PerryXu1/high-voltage-controller/README.md

# high-voltage-controller
PCB to control the output of a high-voltage (30kV) power supply and relay voltage/current data from it
