PerryXu1/high-voltage-controller/Hardware/Components/STM32G431C6T6/Altium/STM32G431C6T6/LQFP48-7x7mm.step

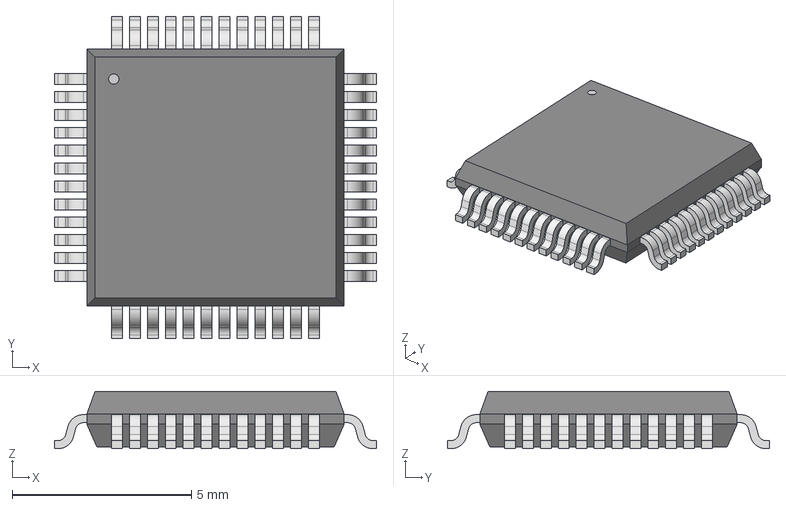
[picture p1: CAD file, 2026-06-20]
Hardware/Components/STM32G431C6T6/Altium/STM32G431C6T6/LQFP48-7x7mm.step
8.99 x 8.99 x 1.60 mm
