PerryXu1/high-voltage-controller/Hardware/Components/TLV9002QDRQ1/Altium/TLV9002QDRQ1/SOIC8_D_TEX.step

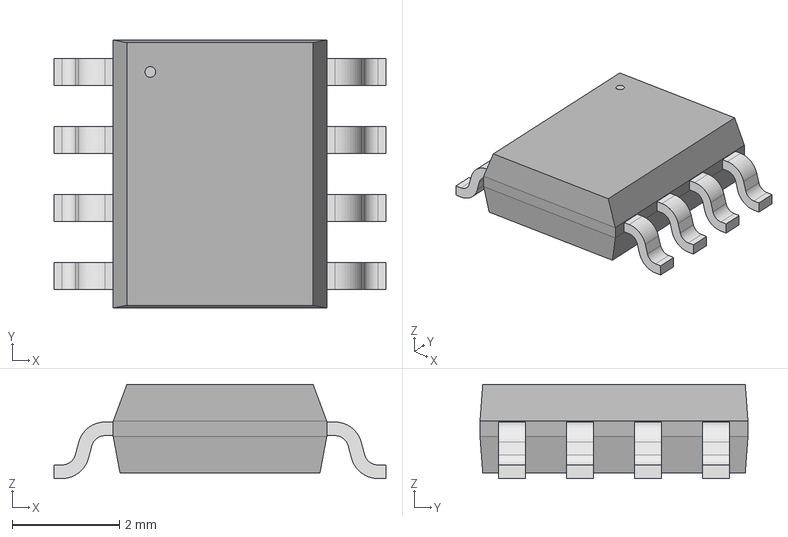
[picture p2: CAD file, 2026-06-20]
Hardware/Components/TLV9002QDRQ1/Altium/TLV9002QDRQ1/SOIC8_D_TEX.step
6.20 x 5.00 x 1.75 mm
