PerryXu1/high-voltage-controller/Hardware/Components/TLV9002QDRQ1/D0008A.stp

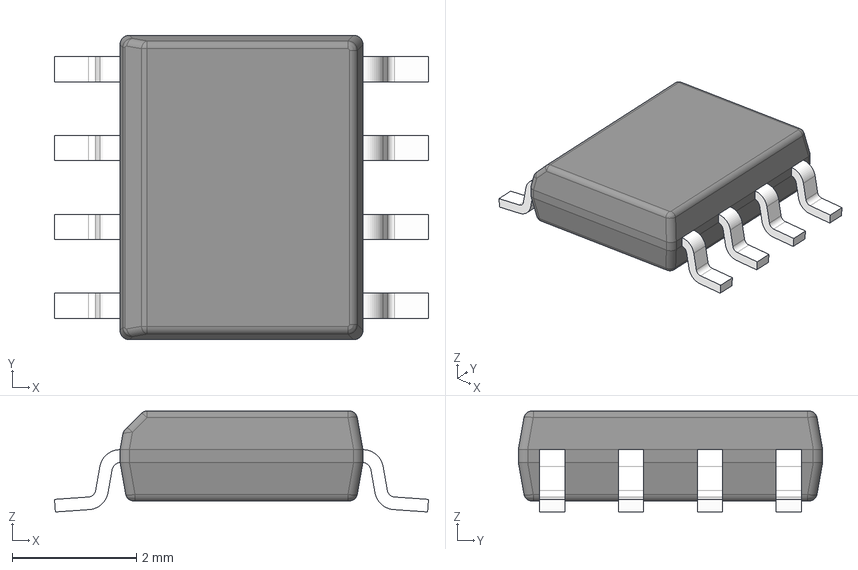
[picture p3: CAD file, 2026-06-20]
Hardware/Components/TLV9002QDRQ1/D0008A.stp
6.02 x 4.90 x 1.63 mm
BODY-SO
LEAD-D0008A x 8
