PerryXu1/high-voltage-controller/Hardware/Components/USB4105_GF_A/USB4105-GF-A.STEP

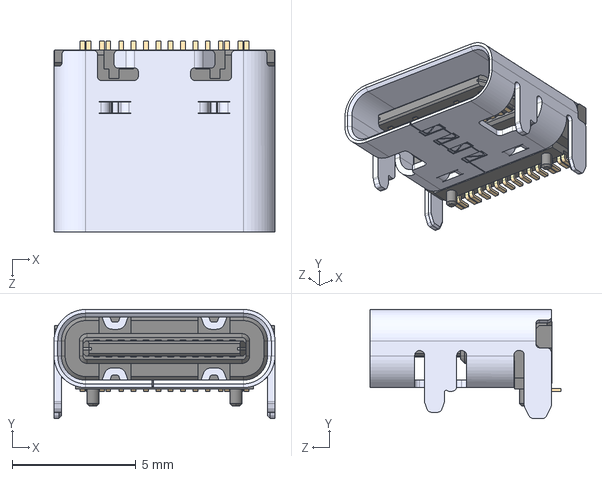
[picture p4: CAD file, 2026-06-20]
Hardware/Components/USB4105_GF_A/USB4105-GF-A.STEP
8.94 x 4.41 x 7.71 mm
