PerryXu1/high-voltage-controller/Hardware/Components/ISO7721FDWR/DW0016B.stp

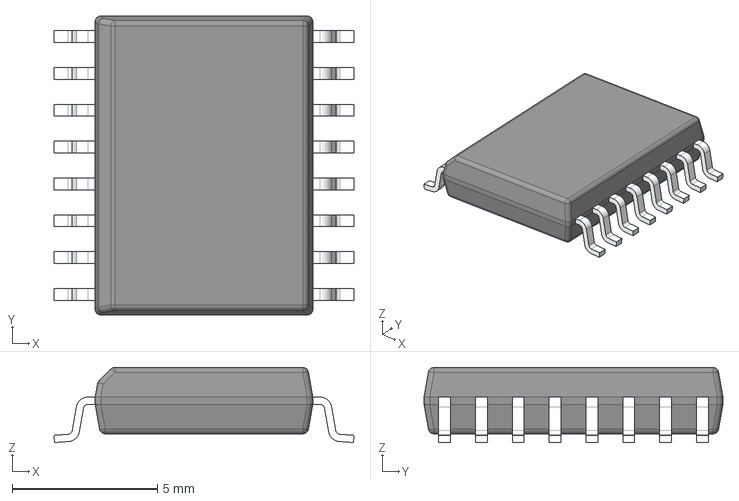
[picture p5: CAD file, 2026-06-20]
Hardware/Components/ISO7721FDWR/DW0016B.stp
10.3 x 10.3 x 2.59 mm
BODY-SOIC
LEAD-DW0016 x 16
