PerryXu1/high-voltage-controller/(list of files, cad)

Other CAD files:
Hardware/Components/STM32G431C6T6/LQFP48-7x7mm.step
