PerryXu1/high-voltage-controller/Hardware/high_voltage_controller/high_voltage_controller.pdf

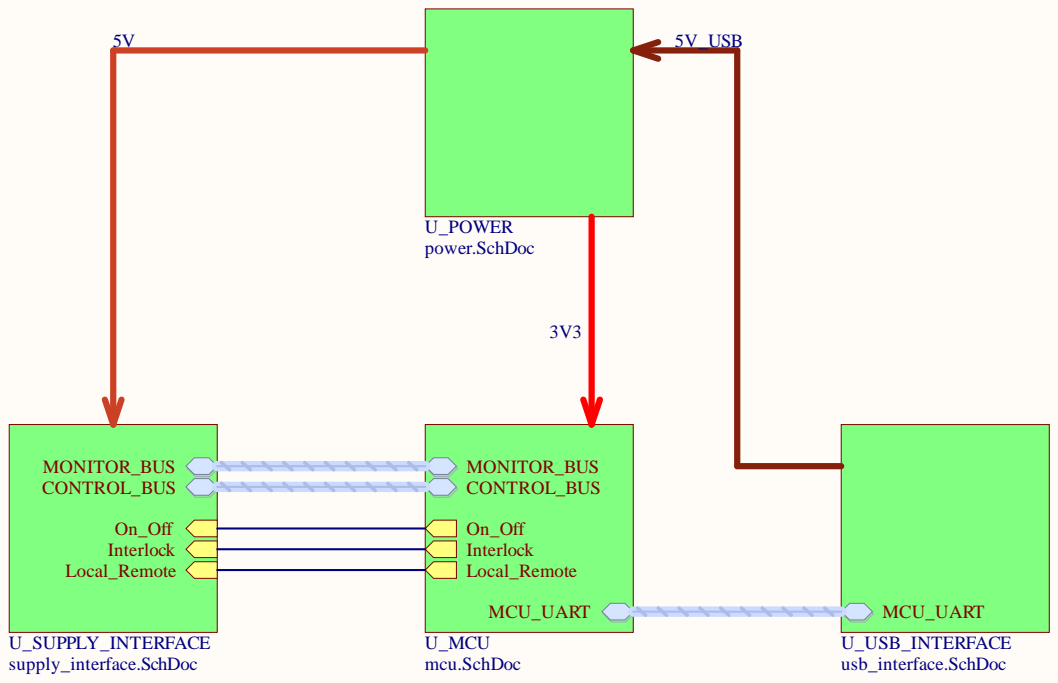
[picture p6: page 1]

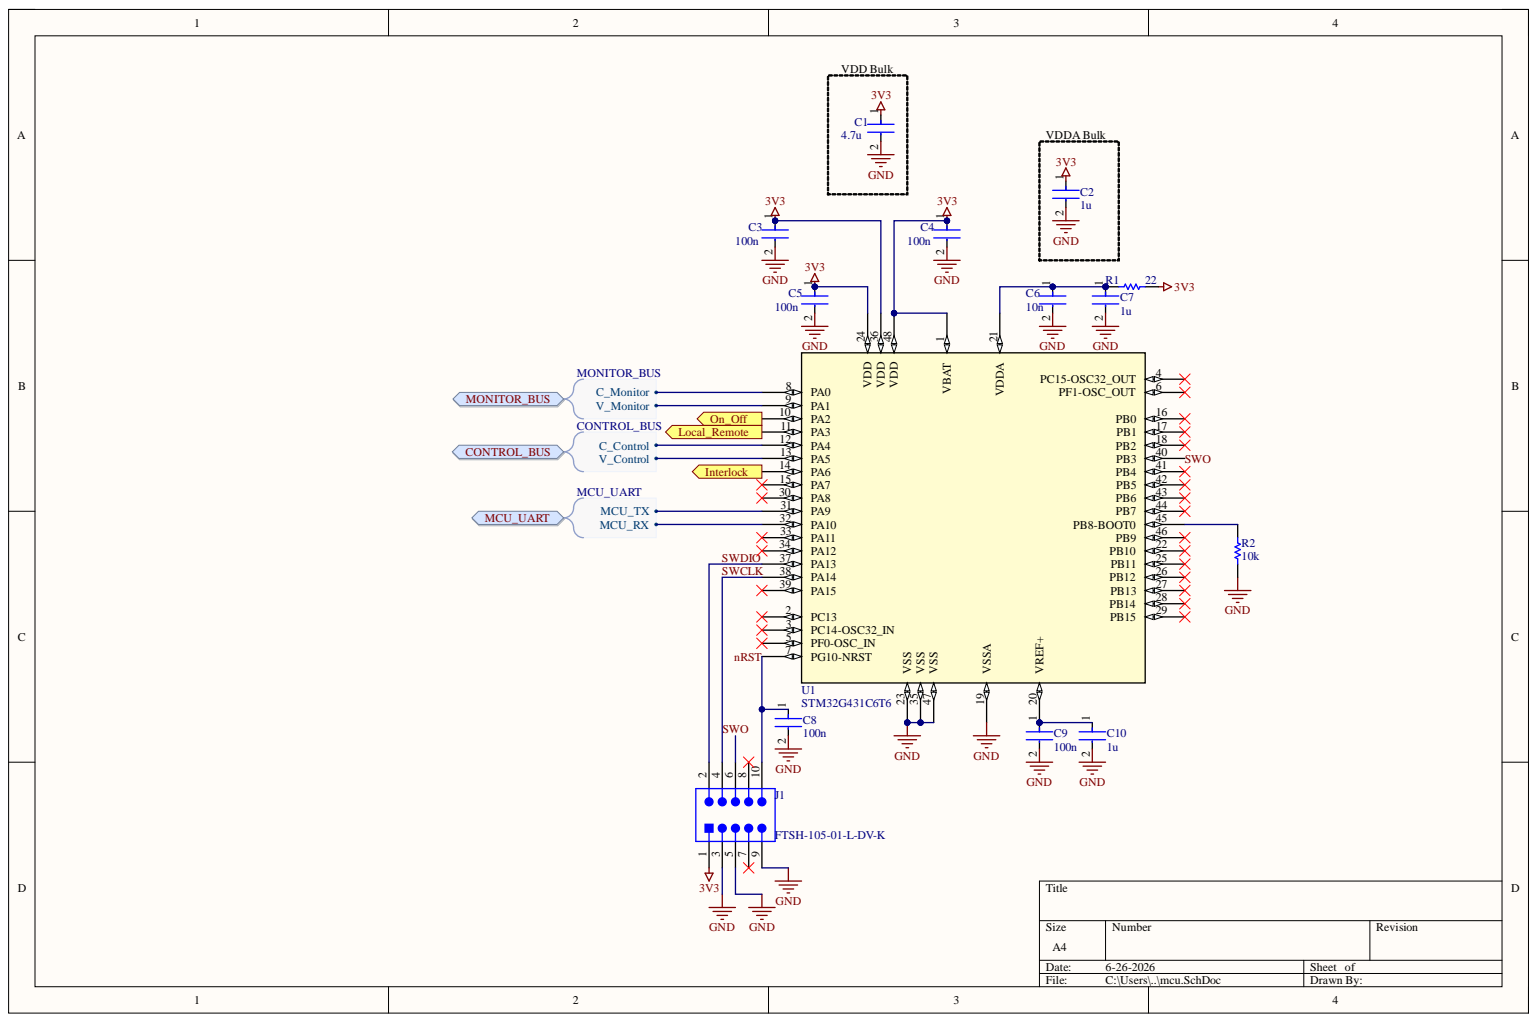
[picture p7: page 2]

SWCLK | PA14 38
nRST SWO | PA15 39

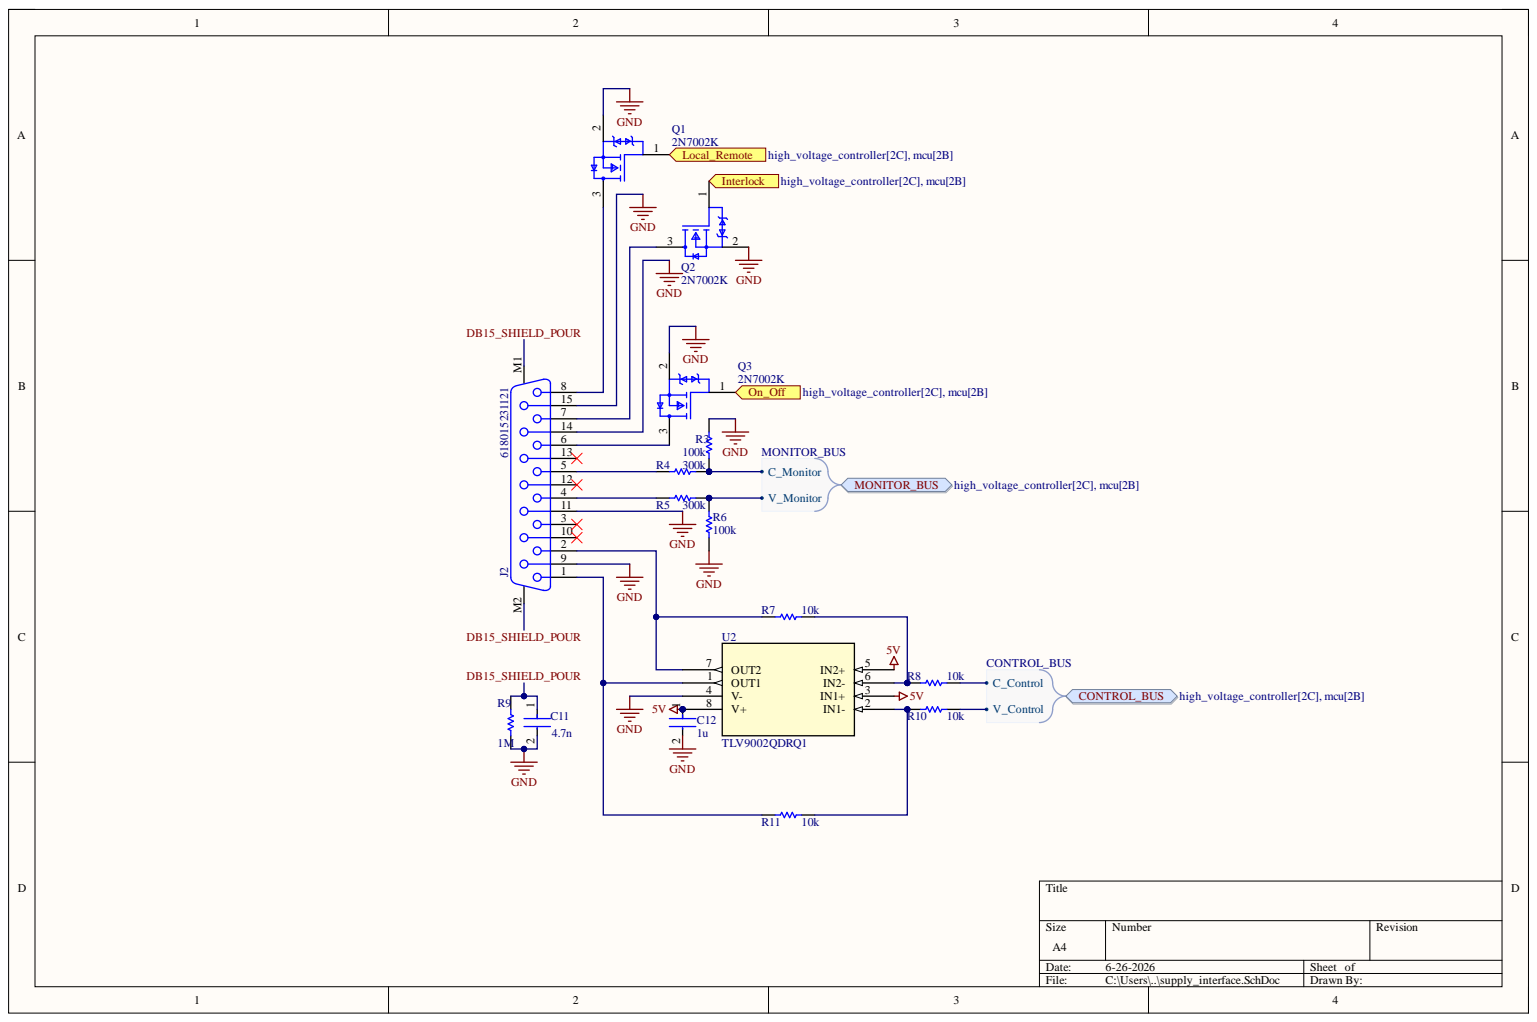
[picture p8: page 3]

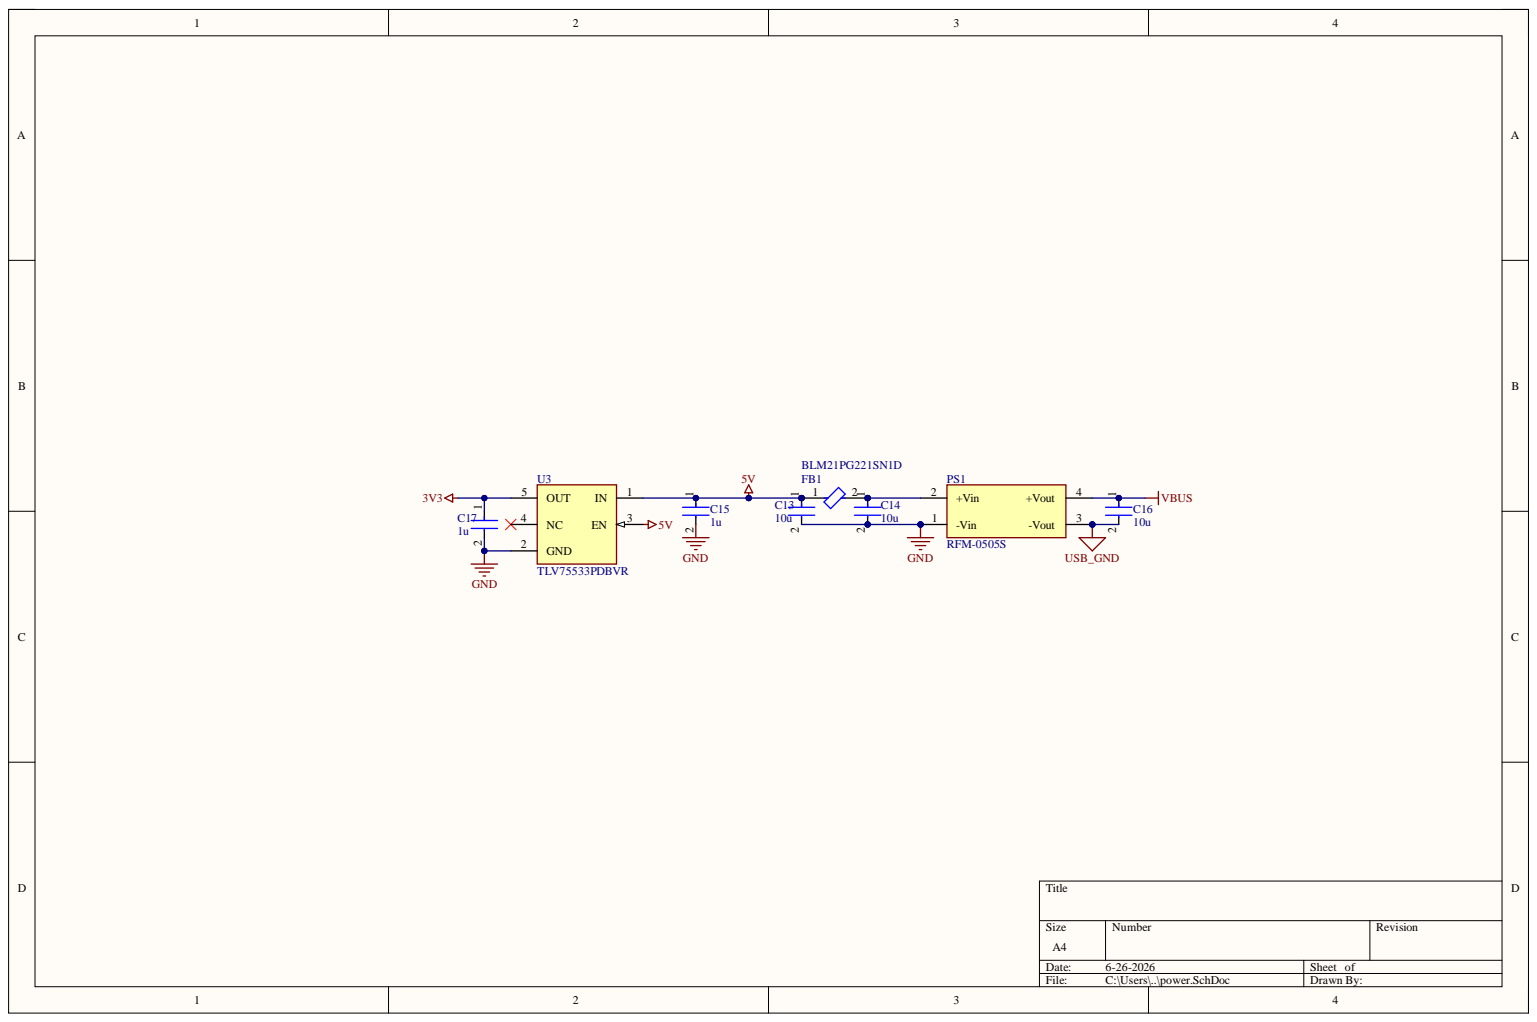
[picture p9: page 4]

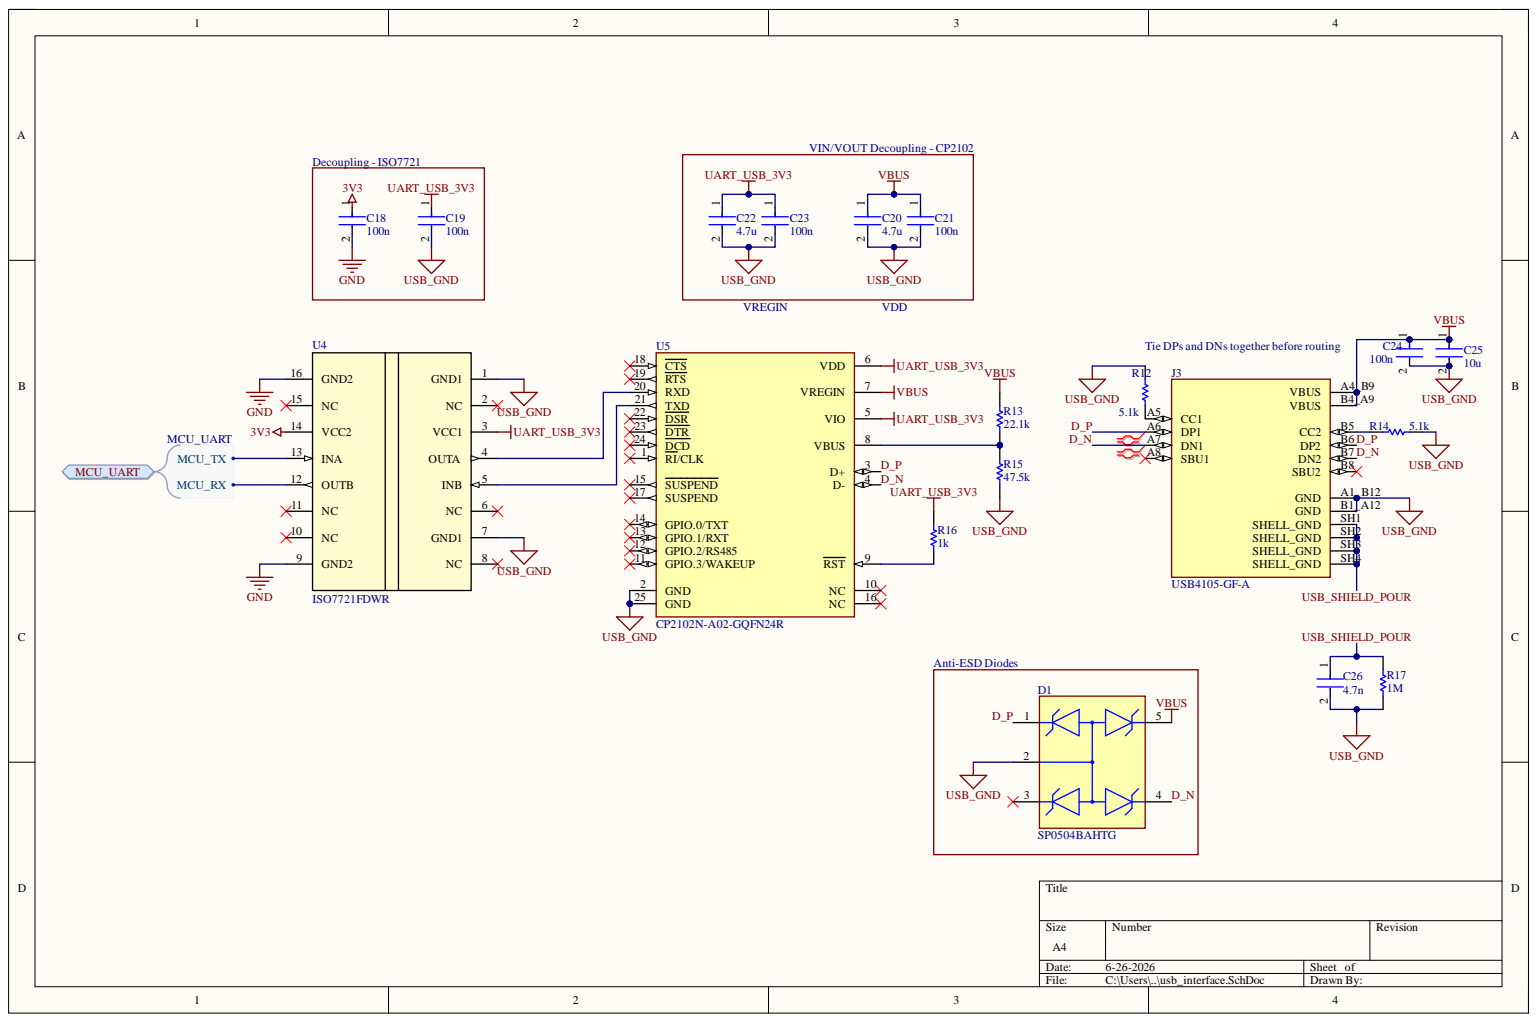
[picture p10: page 5]

3 | USB_ G N D | 2 2

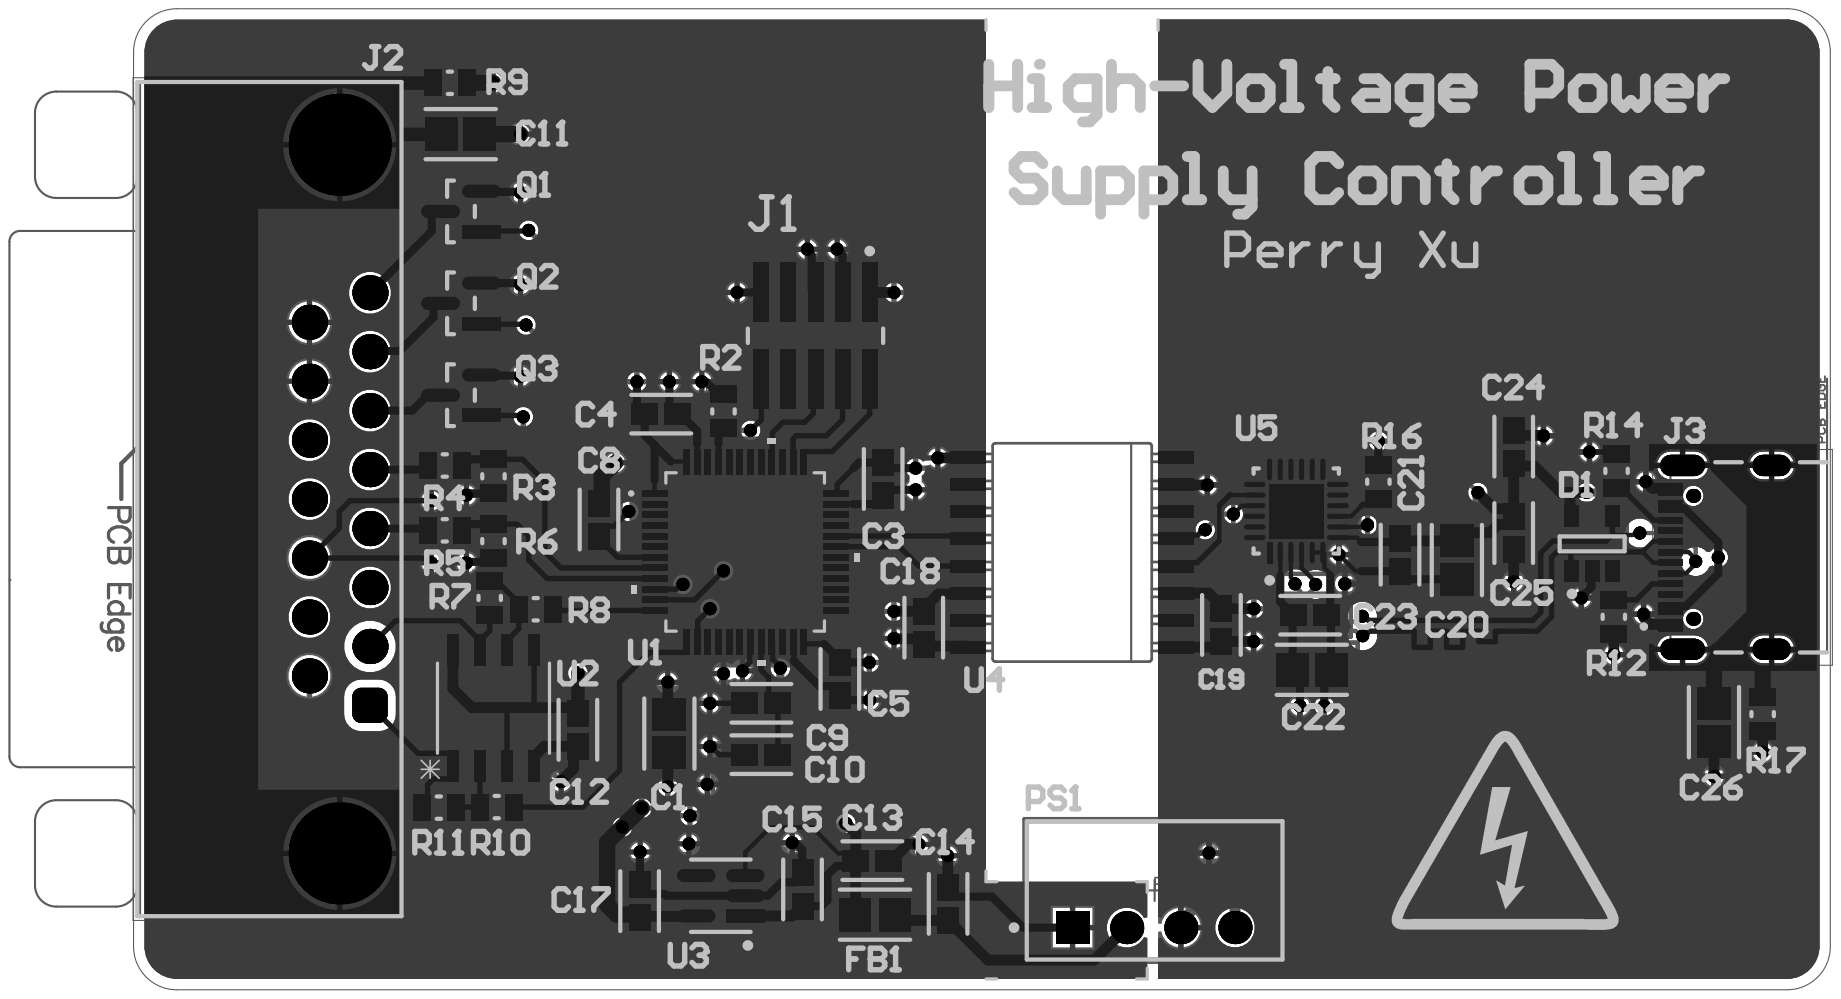
[picture p11: page 6]
