PerryXu1/high-voltage-controller/(list of files, drawings)

Other design files:
Hardware/Components/618015231121/618015231121.PcbLib
Hardware/Components/618015231121/618015231121.SchLib
Hardware/Components/618015231121/618015231121/618015231121.PcbLib
Hardware/Components/618015231121/618015231121/618015231121.SchLib
Hardware/Components/BLM21PG221SN1D/BLM21PG221SN1D.PcbLib
Hardware/Components/BLM21PG221SN1D/BLM21PG221SN1D.SchLib
Hardware/Components/BLM21PG221SN1D/BLM21PG221SN1D/BLM21PG221SN1D.PcbLib
Hardware/Components/BLM21PG221SN1D/BLM21PG221SN1D/BLM21PG221SN1D.SchLib
Hardware/Components/CC0603KRX7R9BB104/CC0603KRX7R9BB104.PcbLib
Hardware/Components/CC0603KRX7R9BB104/CC0603KRX7R9BB104.SchLib
Hardware/Components/CC0603KRX7R9BB104/CC0603KRX7R9BB104/CC0603KRX7R9BB104.PcbLib
Hardware/Components/CC0603KRX7R9BB104/CC0603KRX7R9BB104/CC0603KRX7R9BB104.SchLib
Hardware/Components/CC0805KKX5R5BB475/CC0805KKX5R5BB475.PcbLib
Hardware/Components/CC0805KKX5R5BB475/CC0805KKX5R5BB475.SchLib
Hardware/Components/CC0805KKX5R5BB475/CC0805KKX5R5BB475/CC0805KKX5R5BB475.PcbLib
Hardware/Components/CC0805KKX5R5BB475/CC0805KKX5R5BB475/CC0805KKX5R5BB475.SchLib
Hardware/Components/CP2102N-A02-GQFN24R/CP2102N-A02-GQFN24R.PcbLib
Hardware/Components/CP2102N-A02-GQFN24R/CP2102N-A02-GQFN24R.SchLib
Hardware/Components/CP2102N-A02-GQFN24R/CP2102N-A02-GQFN24R/CP2102N-A02-GQFN24R.PcbLib
Hardware/Components/CP2102N-A02-GQFN24R/CP2102N-A02-GQFN24R/CP2102N-A02-GQFN24R.SchLib
Hardware/Components/FTSH-105-01-L-DV-K/FTSH-105-01-L-DV-K.PcbLib
Hardware/Components/FTSH-105-01-L-DV-K/FTSH-105-01-L-DV-K.SchLib
Hardware/Components/FTSH-105-01-L-DV-K/FTSH-105-01-L-DV-K/FTSH-105-01-L-DV-K.PcbLib
Hardware/Components/FTSH-105-01-L-DV-K/FTSH-105-01-L-DV-K/FTSH-105-01-L-DV-K.SchLib
Hardware/Components/ISO7721FDWR/Altium/ISO7721FDWR.PcbLib
Hardware/Components/ISO7721FDWR/Altium/ISO7721FDWR.SchLib
Hardware/Components/RC0805FR-0710KL/RC0805FR-0710KL.PcbLib
Hardware/Components/RC0805FR-0710KL/RC0805FR-0710KL.SchLib
Hardware/Components/RC0805FR-0710KL/RC0805FR-0710KL/RC0805FR-0710KL.PcbLib
Hardware/Components/RC0805FR-0710KL/RC0805FR-0710KL/RC0805FR-0710KL.SchLib
Hardware/Components/RFM-0505S/RFM-0505S.PcbLib
Hardware/Components/RFM-0505S/RFM-0505S.SchLib
Hardware/Components/RFM-0505S/RFM-0505S/RFM-0505S.PcbLib
Hardware/Components/RFM-0505S/RFM-0505S/RFM-0505S.SchLib
Hardware/Components/SN7002K/SN7002K.PcbLib
Hardware/Components/SN7002K/SN7002K.SchLib
Hardware/Components/SN7002K/SN7002K/SN7002K.PcbLib
Hardware/Components/SN7002K/SN7002K/SN7002K.SchLib
Hardware/Components/SP0504BAHTG/SP0504BAHTG.PcbLib
Hardware/Components/SP0504BAHTG/SP0504BAHTG.SchLib
Hardware/Components/SP0504BAHTG/SP0504BAHTG/SP0504BAHTG.PcbLib
Hardware/Components/SP0504BAHTG/SP0504BAHTG/SP0504BAHTG.SchLib
Hardware/Components/STM32G431C6T6/Altium/STM32G431C6T6/STM32G431C6T6.PcbLib
Hardware/Components/STM32G431C6T6/Altium/STM32G431C6T6/STM32G431C6T6.SchLib
Hardware/Components/TLV9002QDRQ1/Altium/TLV9002QDRQ1/TLV9002QDRQ1.PcbLib
Hardware/Components/TLV9002QDRQ1/Altium/TLV9002QDRQ1/TLV9002QDRQ1.SchLib
Hardware/Components/TLV75533PDBVR/TLV75533PDBVR.PcbLib
Hardware/Components/TLV75533PDBVR/TLV75533PDBVR.SchLib
Hardware/Components/TLV75533PDBVR/TLV75533PDBVR/TLV75533PDBVR.PcbLib
Hardware/Components/TLV75533PDBVR/TLV75533PDBVR/TLV75533PDBVR.SchLib
Hardware/Components/USB4105_GF_A/USB4105-GF-A/GCT_USB4105-GF-A.PcbLib
Hardware/Components/USB4105_GF_A/USB4105-GF-A/USB4105-GF-A.SchLib
Hardware/high_voltage_controller/high_voltage_controller.PcbDoc
Hardware/high_voltage_controller/high_voltage_controller.PcbLib
Hardware/high_voltage_controller/high_voltage_controller.PrjPcb
Hardware/high_voltage_controller/high_voltage_controller.SchDoc
Hardware/high_voltage_controller/high_voltage_controller.SchLib
Hardware/high_voltage_controller/mcu.SchDoc
Hardware/high_voltage_controller/power.SchDoc
Hardware/high_voltage_controller/supply_interface.SchDoc
Hardware/high_voltage_controller/usb_interface.SchDoc
