PerryXu1/high-voltage-controller/Firmware/high-voltage-controller/Core/Src/main.c

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
/* Includes ------------------------------------------------------------------*/
#include "main.h"

/* USER CODE BEGIN Includes */
#include <inttypes.h>

/* USER CODE END Includes */

ADC_HandleTypeDef hadc1;
DMA_HandleTypeDef hdma_adc1;

DAC_HandleTypeDef hdac1;
DMA_HandleTypeDef hdma_dac1_ch2;

TIM_HandleTypeDef htim6;

UART_HandleTypeDef huart1;

/* USER CODE BEGIN PV */
// Data variables
#define MAX_POINTS 1000
#define V_REF 2.5f // use 2.5V analog reference voltage
#define CURRENT_LIMIT_VOLTAGE 0.2f
#define ADC_READ_PERIOD 20 // in ms

// TEST
volatile uint32_t dac_index = 0;
uint16_t current_dac_value = 0;

// GPIO variables
#define CTRL_PORT        GPIOA
#define PIN_OUTPUT_CTRL  GPIO_PIN_10
#define PIN_REMOTE_CTRL  GPIO_PIN_11
#define PIN_INTERLOCK    GPIO_PIN_14

// MCU state logic
typedef enum {
  STATE_WAIT_HEADER,
  STATE_WAIT_PAYLOAD,
  STATE_READY,
  STATE_RUNNING
} AppState_t;

volatile AppState_t sys_state = STATE_WAIT_HEADER;

// RX: Signal Data
typedef struct __attribute__((packed)) {
    char header; // 'D' for data
    uint32_t num_points;
    float time_step;
} DataHeader_t;

DataHeader_t rx_header;
float rx_voltages[MAX_POINTS];
uint16_t dac_buffer[MAX_POINTS]; 
char rx_flag;

// Misc flags
// 2 bytes: rx_cmd[0] = Command (S, O), rx_cmd[1] = Parameter (1 or 0)
// S: start experiment, O: turn off
uint8_t rx_cmd[2];

// TX: ADC Data
uint16_t adc_values[2]; // 0: voltage, 1: current

typedef struct __attribute__((packed)) {
    uint16_t sync_word; // 0xA5A5
    uint16_t v_adc;
    uint16_t i_adc;
} TelemetryPacket_t;

TelemetryPacket_t tx_packet = { .sync_word = 0xA5A5 };
uint32_t last_tx_tick = 0;
/* USER CODE END PV */

void SystemClock_Config(void);
static void MX_GPIO_Init(void);
static void MX_DMA_Init(void);
static void MX_DAC1_Init(void);
static void MX_TIM6_Init(void);
static void MX_ADC1_Init(void);
static void MX_USART1_UART_Init(void);
/* USER CODE BEGIN 0 */
void Configure_TIM6_TimeStep(float dt_minutes) {
  float dt_seconds = dt_minutes * 60.0f;
  HAL_TIM_Base_Stop(&htim6);

  uint32_t prescaler = 15999; 
  uint32_t arr_value = (uint32_t)(dt_seconds * 10000.0f) - 1;

  if (arr_value > 65535) {
      prescaler = 63999; 
      arr_value = (uint32_t)(dt_seconds * 2500.0f) - 1;
  }

  __HAL_TIM_SET_PRESCALER(&htim6, prescaler);
  __HAL_TIM_SET_AUTORELOAD(&htim6, arr_value);

  htim6.Instance->EGR = TIM_EGR_UG;

  __HAL_TIM_SET_COUNTER(&htim6, 0); 

}

void HAL_UART_RxCpltCallback(UART_HandleTypeDef *huart) {
  if (huart->Instance == USART1) {

      // State logic
      switch (sys_state) {
          case STATE_WAIT_HEADER:
              if (rx_header.header == 'D') {
                  sys_state = STATE_WAIT_PAYLOAD;
                  // Read incoming data
                  HAL_UART_Receive_IT(&huart1, (uint8_t*)rx_voltages, rx_header.num_points * sizeof(float));
              } else {
                  // Invalid data; flush and try again
                  HAL_UART_Receive_IT(&huart1, (uint8_t*)&rx_header, sizeof(DataHeader_t));
              }
              break;

          case STATE_WAIT_PAYLOAD:
              // Process data into DAC inputs
              for (uint32_t i = 0; i < rx_header.num_points; i++) {
                  dac_buffer[i] = rx_voltages[i];
              }

              // Set timer speed
              Configure_TIM6_TimeStep(rx_header.time_step);

              // Tell PC the MCU is ready
              uint8_t ready_msg = 'R';
              HAL_UART_Transmit_IT(&huart1, &ready_msg, 1);
              
              sys_state = STATE_READY;

              __HAL_UART_CLEAR_OREFLAG(&huart1);
              __HAL_UART_CLEAR_NEFLAG(&huart1);
              __HAL_UART_CLEAR_FEFLAG(&huart1);

              uint32_t dummy = huart1.Instance->RDR;
              (void)dummy;

              // Now re-arm the interrupt
              HAL_UART_Receive_IT(&huart1, rx_cmd, 2);

              HAL_UART_Receive_IT(&huart1, rx_cmd, 2);
              break;

          case STATE_READY:
          case STATE_RUNNING:
              // S: Start experiment
              if (sys_state == STATE_READY && rx_cmd[0] == 'S') {
                  HAL_TIM_Base_Stop(&htim6);

                  __HAL_DAC_CLEAR_FLAG(&hdac1, DAC_FLAG_DMAUDR2);

                  WRITE_REG(DMA1->IFCR, DMA_IFCR_CTCIF2 | DMA_IFCR_CHTIF2 | DMA_IFCR_CTEIF2 | DMA_IFCR_CGIF2);                  
                  // Set DAC CH2 to output data
                  HAL_DAC_Start_DMA(&hdac1, DAC_CHANNEL_2, (uint32_t*) dac_buffer, rx_header.num_points, DAC_ALIGN_12B_R);
                  HAL_TIM_Base_Start(&htim6);
                  
                  // Set interlock ON
                  HAL_GPIO_WritePin(CTRL_PORT, PIN_OUTPUT_CTRL, GPIO_PIN_SET);
                  sys_state = STATE_RUNNING;
              }

              // O: Turn Off flag
              else if (rx_cmd[0] == 'O') { 
                  HAL_TIM_Base_Stop(&htim6);
                  HAL_DAC_Stop_DMA(&hdac1, DAC_CHANNEL_2);
                  
                  // Set output off
                  HAL_GPIO_WritePin(CTRL_PORT, PIN_OUTPUT_CTRL, GPIO_PIN_RESET);
                  sys_state = STATE_READY;
              }
              // C: Remote / Local Control flag
              else if (rx_cmd[0] == 'C') {
                  if (rx_cmd[1] == 1 || rx_cmd[1] == '1') {
                      HAL_GPIO_WritePin(CTRL_PORT, PIN_REMOTE_CTRL, GPIO_PIN_SET);   // Remote (Pin 11 HIGH)
                  } else if (rx_cmd[1] == 0 || rx_cmd[1] == '0') {
                      HAL_GPIO_WritePin(CTRL_PORT, PIN_REMOTE_CTRL, GPIO_PIN_RESET); // Front Panel / Local (Pin 11 LOW)
                  }
              }
              
              HAL_UART_Receive_IT(&huart1, rx_cmd, 2);
              break;
          
      }
  }
}
/* USER CODE END 0 */

/**
  * @brief  The application entry point.
  * @retval int
  */
int main(void)
{

  /* MCU Configuration--------------------------------------------------------*/

  /* Reset of all peripherals, Initializes the Flash interface and the Systick. */
  HAL_Init();

  /* Configure the system clock */
  SystemClock_Config();

  /* Initialize all configured peripherals */
  MX_GPIO_Init();
  MX_DMA_Init();
  MX_DAC1_Init();
  MX_TIM6_Init();
  MX_ADC1_Init();
  MX_USART1_UART_Init();
  /* USER CODE BEGIN 2 */

  // Set DAC CH1 output | limit / 2 since op amp gain is 2
  uint32_t current_limit_dac_val = (uint32_t) (((CURRENT_LIMIT_VOLTAGE / 2) / V_REF) * 4095.0f);
  HAL_DAC_SetValue(&hdac1, DAC_CHANNEL_1, DAC_ALIGN_12B_R, current_limit_dac_val);
  HAL_DAC_Start(&hdac1, DAC_CHANNEL_1);

  // Start ADC monitoring
  HAL_ADCEx_Calibration_Start(&hadc1, ADC_SINGLE_ENDED);
  HAL_ADC_Start_DMA(&hadc1, (uint32_t*)adc_values, 2);

  // State logic
  sys_state = STATE_WAIT_HEADER;
  HAL_UART_Receive_IT(&huart1, (uint8_t*)&rx_header, sizeof(DataHeader_t));

  /* USER CODE END 2 */

  /* Infinite loop */
  /* USER CODE BEGIN WHILE */
  while (1)
  {
    /* USER CODE END WHILE */

    /* USER CODE BEGIN 3 */
    if (sys_state == STATE_RUNNING) {
        
        // Transmit ADC data every 20ms (50 Hz)
        if (HAL_GetTick() - last_tx_tick >= ADC_READ_PERIOD) {
            
            if (huart1.gState == HAL_UART_STATE_READY) {
                last_tx_tick = HAL_GetTick();
                
                tx_packet.v_adc = adc_values[0];
                tx_packet.i_adc = adc_values[1];
                
                // Send ADC data to PC
                HAL_UART_Transmit_IT(&huart1, (uint8_t*)&tx_packet, sizeof(TelemetryPacket_t));
            }
        }
    }
  }
  /* USER CODE END 3 */
}

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
