PerryXu1/high-voltage-controller/Firmware/high-voltage-controller/high-voltage-controller.ioc

Mcu.UserName=STM32G431C6Tx
PA0.Signal=ADC1_IN1
PA1.Signal=ADC1_IN2
PA10.Signal=USART1_RX
PA13.Signal=SYS_JTMS-SWDIO
PA14.Signal=SYS_JTCK-SWCLK
PA2.Signal=GPIO_Output
PA3.Signal=GPIO_Output
PA4.Signal=SharedAnalog_PA4
PA5.Signal=SharedAnalog_PA5
PA6.Signal=GPIO_Output
PA9.Signal=USART1_TX
PB3.Signal=SYS_JTDO-SWO
PB8-BOOT0.Signal=GPIO_Input
