PerryXu1/high-voltage-controller/(commit log)

2026-06-16 feat: initial commit
    [PCB1.PcbDoc, PcbLib1.PcbLib, Schlib1.SchLib, Sheet1.SchDoc, high_voltage_controller.PrjPcb]
2026-06-20 feat: add symbols and footprints for most components
    [CP2102N-A02-GQFN24R.PcbLib, CP2102N-A02-GQFN24R.SchLib, D0008A.stp, DW0016B.stp, GCT_USB4105-GF-A.PcbLib, ISO7721FDWR.PcbLib, ISO7721FDWR.SchLib, LQFP48-7x7mm.step]
2026-06-20 feat: add resistor schematics and footprints
    [618015231121.PcbLib, 618015231121.SchLib, PcbLib1.PcbLib, RC0805FR-0710KL.PcbLib, RC0805FR-0710KL.SchLib, Schlib1.SchLib]
2026-06-20 feat: add cap schematics and footprints
    [BLM21PG221SN1D.PcbLib, BLM21PG221SN1D.SchLib, CC0603KRX7R9BB104.PcbLib, CC0603KRX7R9BB104.SchLib, CC0805KKX5R5BB475.PcbLib, CC0805KKX5R5BB475.SchLib, PcbLib1.PcbLib, Schlib1.SchLib]
2026-06-20 feat: add all components to schematic and footprint library
    [FTSH-105-01-L-DV-K.PcbLib, FTSH-105-01-L-DV-K.SchLib, PcbLib1.PcbLib, Schlib1.SchLib]
2026-06-21 feat: route mcu power in schematic
    [Sheet1.SchDoc]
2026-06-21 feat: wire swd header in schematic
    [Sheet1.SchDoc]
2026-06-21 feat: add decoupling to nrst line
    [Sheet1.SchDoc]
2026-06-21 feat: wire db15 connector schematic
    [Schlib1.SchLib, Sheet1.SchDoc]
2026-06-21 feat: add shield caps/resistors to db15 connector in schematic
    [Sheet1.SchDoc]
2026-06-21 feat: changes
    [Sheet1.SchDoc]
2026-06-22 feat: reorganization
    [Sheet1.SchDoc, outline.SchDoc]
2026-06-22 feat: reorganization of structure
    [control.SchDoc, high_voltage_controller.PrjPcb, high_voltage_controller.SchDoc, mcu.SchDoc, outline.SchDoc, power.SchDoc, supply_interface.SchDoc, usb_interface.SchDoc]
2026-06-22 feat: reorganize mcu into separate sheet
    [high_voltage_controller.PrjPcb, high_voltage_controller.SchDoc, mcu.SchDoc]
2026-06-22 feat: mcu schematic reorganization
    [mcu.SchDoc]
2026-06-22 feat: reorganize supply control into separate file
    [control.SchDoc, high_voltage_controller.PrjPcb, high_voltage_controller.SchDoc, supply_interface.SchDoc]
2026-06-22 feat: route usb subsystem schematic
    [PcbLib1.PcbLib, SP0504BAHTG.PcbLib, SP0504BAHTG.SchLib, Schlib1.SchLib, high_voltage_controller.SchDoc, mcu.SchDoc, supply_interface.SchDoc, usb_interface.SchDoc]
2026-06-22 feat: route power schematic
    [high_voltage_controller.SchDoc, mcu.SchDoc, power.SchDoc, usb_interface.SchDoc]
2026-06-22 feat: schematic overview updates
    [high_voltage_controller.SchDoc]
2026-06-22 feat: renaming of libraries
    [high_voltage_controller.PcbDoc, high_voltage_controller.PcbLib, high_voltage_controller.PrjPcb, high_voltage_controller.SchLib]
2026-06-22 feat: change pcb layer stackup
    [high_voltage_controller.PcbDoc]
2026-06-22 feat: add net classes and rules
    [high_voltage_controller.PcbDoc, high_voltage_controller.SchLib, mcu.SchDoc, power.SchDoc, supply_interface.SchDoc, usb_interface.SchDoc]
2026-06-22 feat: route mcu power
    [high_voltage_controller.PcbDoc, high_voltage_controller.SchDoc]
2026-06-22 feat: swd header routing
    [high_voltage_controller.PcbDoc]
2026-06-22 feat: db15 connector shield pour
2026-06-23 feat: control mosfet routing
    [supply_interface.SchDoc]
2026-06-23 feat: route monitor lines on pcb
2026-06-23 feat: route control amplifier
    [power.SchDoc, supply_interface.SchDoc, usb_interface.SchDoc]
2026-06-23 feat: route isolator + adjust power/ground planes
2026-06-24 feat: route usb connector
    [usb_interface.SchDoc]
2026-06-24 feat: second revision, add capacitors to vbus
    [high_voltage_controller.PrjPcb, high_voltage_controller.SchDoc, mcu.SchDoc, power.SchDoc, supply_interface.SchDoc, usb_interface.SchDoc]
2026-06-24 feat: silkscreen adjustments
2026-06-25 feat: op amp changes
    change op amp pinout to match footprint. minimize 5V power trace length. rearrange components to reduce noise coupling into op amp signal line
    [high_voltage_controller.SchLib, mcu.SchDoc, supply_interface.SchDoc]
2026-06-25 feat: second round of revision
    [high_voltage_controller.PcbLib, high_voltage_controller.SchDoc, high_voltage_controller.SchLib, mcu.SchDoc, power.SchDoc, supply_interface.SchDoc, usb_interface.SchDoc]
2026-06-26 feat: chjanges
    [high_voltage_controller.GBL, high_voltage_controller.GBO, high_voltage_controller.GBP, high_voltage_controller.GBS, high_voltage_controller.GTL, high_voltage_controller.GTO, high_voltage_controller.GTP, high_voltage_controller.GTS]
2026-06-26 feat: generate fabrication outputs
    [high_voltage_controller.GBL, high_voltage_controller.GBO, high_voltage_controller.GBP, high_voltage_controller.GBS, high_voltage_controller.GTL, high_voltage_controller.GTO, high_voltage_controller.GTP, high_voltage_controller.GTS]
2026-07-10 feat: start firmware. configure stm32 pins and timers
2026-07-17 feat: pcb fixes
    [high_voltage_controller.GBL, high_voltage_controller.GBO, high_voltage_controller.GBP, high_voltage_controller.GBS, high_voltage_controller.GTL, high_voltage_controller.GTO, high_voltage_controller.GTP, high_voltage_controller.GTS]
2026-07-17 feat: brief changes
    [high_voltage_controller.GBL, high_voltage_controller.GBO, high_voltage_controller.GBP, high_voltage_controller.GBS, high_voltage_controller.GTL, high_voltage_controller.GTO, high_voltage_controller.GTP, high_voltage_controller.GTS]
2026-07-26 feat: op amp changes
    [high_voltage_controller.PcbDoc, high_voltage_controller.SchLib, supply_interface.SchDoc]
2026-07-27 feat: fixes
    [high_voltage_controller.PcbDoc, high_voltage_controller.SchLib, supply_interface.SchDoc]
2026-08-09 feat: add function to transmit data to pcb
2026-08-09 feat: start experiment button
